Sohcahtoaii/Elegoo-centaury-carbon-Filament-Movement-Sensor/UPGRADE ELEGOO/UPGRADE ELEGOO.kicad_pcb

## KiCad design UPGRADE ELEGOO/UPGRADE ELEGOO.kicad_pcb (2025-07-25)

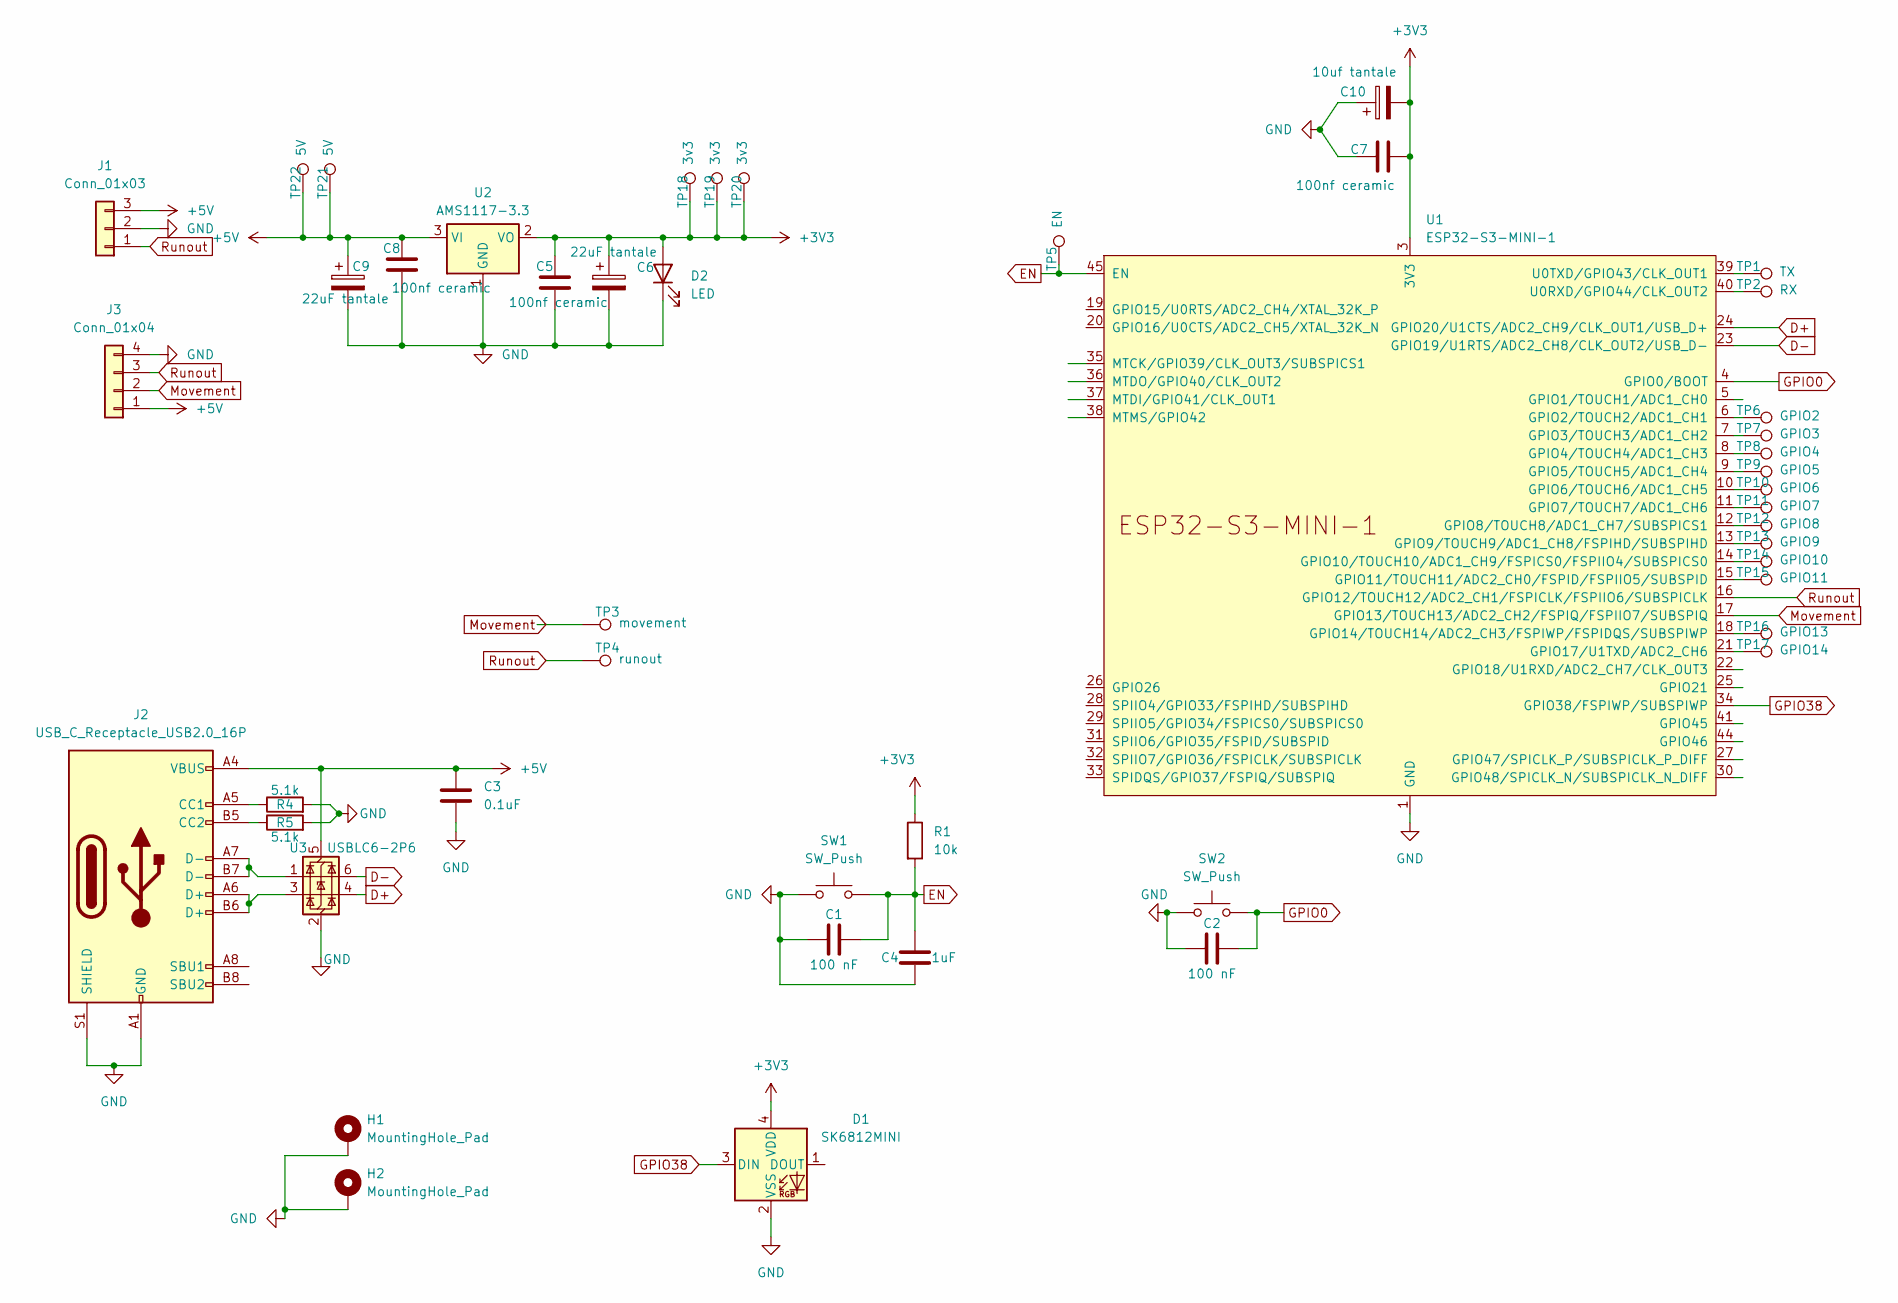
[picture p1: schematic UPGRADE ELEGOO.kicad_sch, Elegoo centaury carbon filament detection upgrade]

Parts:
C1, C2: 100 nF; C_0805_2012Metric_Pad1.18x1.45mm_HandSolder
C3: 0.1uF; C_0805_2012Metric_Pad1.18x1.45mm_HandSolder
C4: 1uF; C_0805_2012Metric_Pad1.18x1.45mm_HandSolder
C5, C7, C8: 100nf ceramic; C_0805_2012Metric_Pad1.18x1.45mm_HandSolder
C6: 22uF tantale; C_1206_3216Metric_Pad1.33x1.80mm_HandSolder
C9: 22uF tantale; C_1206_3216Metric
C10: 10uf tantale; C_1206_3216Metric_Pad1.33x1.80mm_HandSolder
D1: SK6812MINI; LED_SK6812MINI_PLCC4_3.5x3.5mm_P1.75mm
D2: LED; LED_0805_2012Metric
H1, H2: MountingHole_Pad; MountingHole_3.2mm_M3_ISO14580_Pad
J1: Conn_01x03; JST_PH_S3B-PH-K_1x03_P2.00mm_Horizontal
J2: USB_C_Receptacle_USB2.0_16P; USB_C_Receptacle_G-Switch_GT-USB-7010ASV
J3: Conn_01x04; JST_PH_S4B-PH-K_1x04_P2.00mm_Horizontal
R1: 10k; R_0805_2012Metric_Pad1.20x1.40mm_HandSolder
R4, R5: 5.1k; R_0805_2012Metric_Pad1.15x1.40mm
SW1, SW2: SW_Push; SW_Push_1P1T_NO_CK_KMR2
TP1: TX; TestPoint_THTPad_D2.0mm_Drill1.0mm
TP2: RX; TestPoint_THTPad_D2.0mm_Drill1.0mm
TP3: movement; TestPoint_THTPad_D2.0mm_Drill1.0mm
TP4: runout; TestPoint_THTPad_D2.0mm_Drill1.0mm
TP5: EN; TestPoint_THTPad_D2.0mm_Drill1.0mm
TP6: GPIO2; TestPoint_THTPad_D2.0mm_Drill1.0mm
TP7: GPIO3; TestPoint_THTPad_D2.0mm_Drill1.0mm
TP8: GPIO4; TestPoint_THTPad_D2.0mm_Drill1.0mm
TP9: GPIO5; TestPoint_THTPad_D2.0mm_Drill1.0mm
TP10: GPIO6; TestPoint_THTPad_D2.0mm_Drill1.0mm
TP11: GPIO7; TestPoint_THTPad_D2.0mm_Drill1.0mm
TP12: GPIO8; TestPoint_THTPad_D2.0mm_Drill1.0mm
TP13: GPIO9; TestPoint_THTPad_D2.0mm_Drill1.0mm
TP14: GPIO10; TestPoint_THTPad_D2.0mm_Drill1.0mm
TP15: GPIO11; TestPoint_THTPad_D2.0mm_Drill1.0mm
TP16: GPIO13; TestPoint_THTPad_D2.0mm_Drill1.0mm
TP17: GPIO14; TestPoint_THTPad_D2.0mm_Drill1.0mm
TP18, TP19, TP20: 3v3; TestPoint_THTPad_D2.0mm_Drill1.0mm
TP21, TP22: 5V; TestPoint_THTPad_D2.0mm_Drill1.0mm
U1: ESP32-S3-MINI-1
U2: AMS1117-3.3; SOT-223-3_TabPin2
U3: USBLC6-2P6; SOT-666

Connections:
+3V3: C5.1, C6.1, C7.2, C10.2, D1.4 (VDD), D2.2 (A), R1.1, TP18.1, TP19.1, TP20.1, U1.3 (3V3), U2.2 (VO)
+5V: C3.1, C8.1, C9.1, J1.3, J2.A4 (VBUS), J2.A9 (VBUS), J2.B4 (VBUS), J2.B9 (VBUS), J3.1, TP21.1, TP22.1, U2.3 (VI), U3.5 (VBUS)
D+: U1.24 (GPIO20/U1CTS/ADC2_CH9/CLK_OUT1/USB_D+), U3.4 (I/O2)
D-: U1.23 (GPIO19/U1RTS/ADC2_CH8/CLK_OUT2/USB_D-), U3.6 (I/O1)
EN: C1.2, C4.2, R1.2, SW1.2, TP5.1, U1.45 (EN)
GND: C1.1, C2.1, C3.2, C4.1, C5.2, C6.2, C7.1, C8.2, C9.2, C10.1, D1.2 (VSS), D2.1 (K), H1.1, H2.1, J1.2, J2.A1 (GND), J2.A12 (GND), J2.B1 (GND), J2.B12 (GND), J2.S1 (SHIELD), J3.4, R4.2, R5.2, SW1.1, SW2.1, U1.1 (GND), U1.2 (GND), U1.42 (GND), U1.43 (GND), U1.46 (GND), U1.47 (GND), U1.48 (GND), U1.49 (GND), U1.50 (GND), U1.51 (GND), U1.52 (GND), U1.53 (GND), U1.54 (GND), U1.55 (GND), U1.56 (GND), U1.57 (GND), U1.58 (GND), U1.59 (GND), U1.60 (GND), U1.61 (GND), U1.62 (GND), U1.63 (GND), U1.64 (GND), U1.65 (GND), U2.1 (GND), U3.2 (GND)
GPIO0: C2.2, SW2.2, U1.4 (GPIO0/BOOT)
GPIO38: D1.3 (DIN), U1.34 (GPIO38/FSPIWP/SUBSPIWP)
Movement: J3.2, TP3.1, U1.17 (GPIO13/TOUCH13/ADC2_CH2/FSPIQ/FSPIIO7/S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)
unnamed: J2.A5 (CC1), R4.1
unnamed: J2.B5 (CC2), R5.1
unnamed: J2.A6 (D+), J2.B6 (D+), U3.3 (I/O2)
unnamed: J2.A7 (D-), J2.B7 (D-), U3.1 (I/O1)
unnamed: TP6.1, U1.6 (GPIO2/TOUCH2/ADC1_CH1)
unnamed: TP7.1, U1.7 (GPIO3/TOUCH3/ADC1_CH2)
unnamed: TP8.1, U1.8 (GPIO4/TOUCH4/ADC1_CH3)
unnamed: TP9.1, U1.9 (GPIO5/TOUCH5/ADC1_CH4)
unnamed: TP10.1, U1.10 (GPIO6/TOUCH6/ADC1_CH5)
unnamed: TP11.1, U1.11 (GPIO7/TOUCH7/ADC1_CH6)
unnamed: TP12.1, U1.12 (GPIO8/TOUCH8/ADC1_CH7/SUBSPICS1)
unnamed: TP13.1, U1.13 (GPIO9/TOUCH9/ADC1_CH8/FSPIHD/SUBSPIHD)
unnamed: TP14.1, U1.14 (GPIO10/TOUCH10/ADC1_CH9/FSPICS0/FSPIIO4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)
unnamed: TP15.1, U1.15 (GPIO11/TOUCH11/ADC2_CH0/FSPID/FSPIIO5/S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)
unnamed: TP16.1, U1.18 (GPIO14/TOUCH14/ADC2_CH3/FSPIWP/FSPIDQS/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)
unnamed: TP17.1, U1.21 (GPIO17/U1TXD/ADC2_CH6)
unnamed: TP2.1, U1.40 (U0RXD/GPIO44/CLK_OUT2)
unnamed: TP1.1, U1.39 (U0TXD/GPIO43/CLK_OUT1)
Runout: J1.1, J3.3, TP4.1, U1.16 (GPIO12/TOUCH12/ADC2_CH1/FSPICLK/FSPIIO6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)

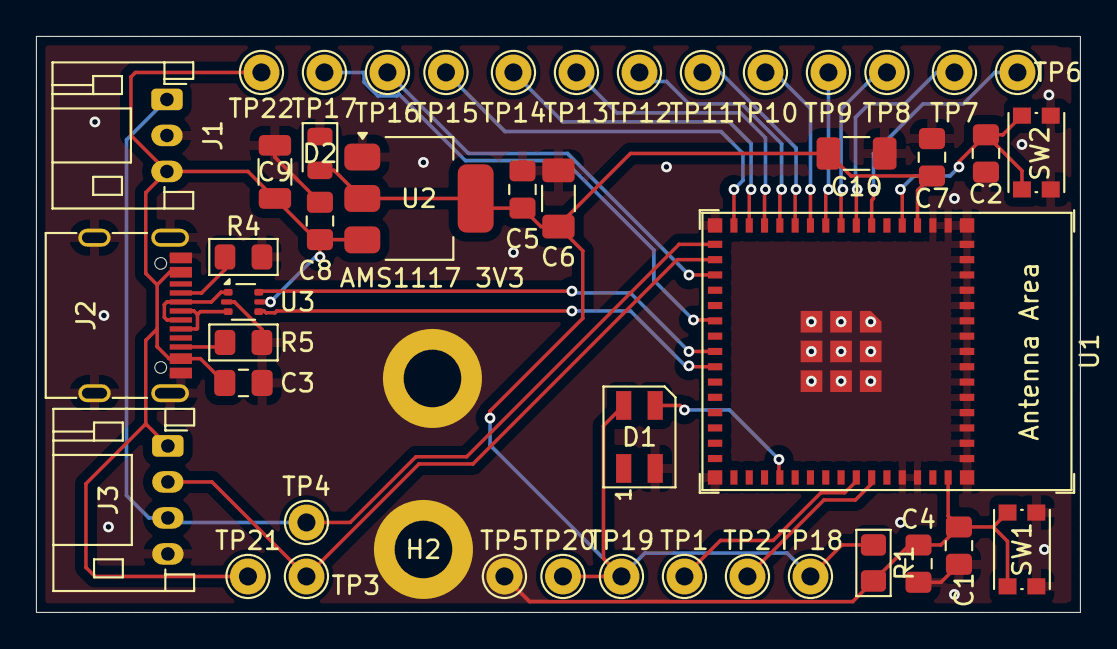
[picture p2: board UPGRADE ELEGOO.kicad_pcb from above]

Board: 2 copper layers, 58.0 x 32.0 mm, 47 parts (0 on the bottom side), 28 nets.
