Sohcahtoaii/Elegoo-centaury-carbon-Filament-Movement-Sensor/(commit log)

2025-07-25 initial upload
    [UPGRADE ELEGOO.kicad_pcb, UPGRADE ELEGOO.kicad_sch]
2025-07-25 Update and rename UPGRADE ELEGOO/bom/ibom.html to UPGRADE ELEGOO/docs/bom/ibom.html
2025-07-25 Update and rename bom/ibom.html to docs/bom/ibom.html
2025-07-25 Update and rename docs/bom/ibom.html to docs/ibom.html
